MicroMidi/NUX-MIDI-Footswitch/images/NUX-Footswitch-Back.jpg

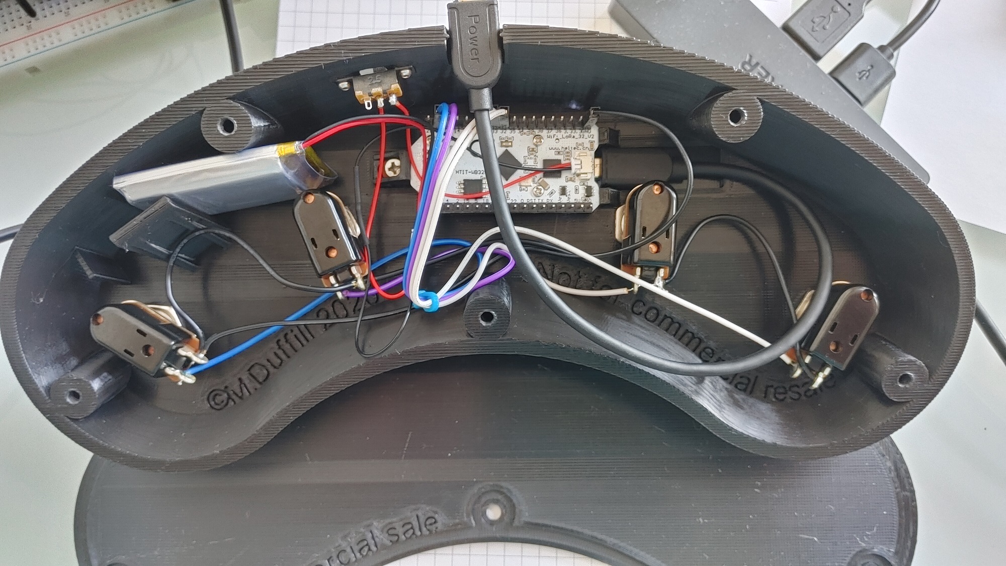
images/NUX-Footswitch-Back.jpg
