MicroMidi/NUX-MIDI-Footswitch/images/NUX-Footswitch-Front.jpg

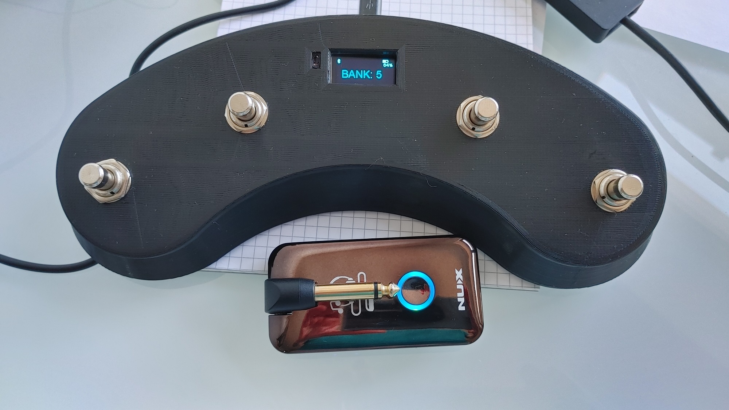
images/NUX-Footswitch-Front.jpg
