MicroMidi/NUX-MIDI-Footswitch/(threads)

Thread 1 (2022-06-10):

Generic ESP32 version?

Celticpure, 2022-06-10:
Any plans to release a generic ESP23 version for those not using the HELTEC boards?? Thank you for your hard work!

MicroMidi, 2022-06-12:
That should be possible - if an external SSD1306 OLED display will be attached to the ESP32 controller. Does this scenario match to your requirement?

Celticpure, 2022-06-12:
Yes that would be exactly my scenario. Thank you.

MicroMidi, 2022-06-29:
At least I have managed so far to modify the code in order to use the generic ESP32 board software and an external SSD1306 OLED library with my "Heltec ESP32 WiFi kit". So there are no longer any dependencies to Heltec software components and the code should work with all generic ESP32 devices that have an SSD1306 OLED display attached which is connected via I2C interface to the ESP32 module.

Final tests will be processed with an ESP32 WROVER module if my external SSD1306 display unit arrives that I ordered a couple of days ago.

So it seems that generic ESP32 support is almost close to release …

Celticpure, 2022-06-29:
Wow! Awesome work thank you for this. I will try and 1106 board also when I get back from holidays and let you know. It should work ok.

Celticpure, 2022-06-30:
Awesome, thank you so much. I will test in the next week or so and report back. Looking forward to this!

MicroMidi, 2022-07-22:
@Celticpure: Any results on testing the ESP32 version in your environment, yet?

Celticpure, 2022-07-22:
Yes the esp32 connects to the app fine. However the switches cannot change the banks. Nothing happens. I have rechecked the code to ensure correct pin assignment to the switches. Not sure what I might be missing here?

MicroMidi, 2022-07-22:
... the esp32 should connect directly to the Mighty Plug - the "Mightier" app is not needed in this setup. If this is the case in your scenario please doublecheck if the push buttons are tied to GND and not to VCC. The code initializes the ESP32-PINS for the push buttons with the "pull-up" feature. Hence, they are on VCC-level if they are not pushed. The push operation should change the level to GND and therefore the connection to GND is required. You can see that on the wiring scheme in the project description. Hope this helps ...

MicroMidi, 2022-08-05:
@Celticpure: Any need for further assistance or did you manage to get this to work?

MicroMidi, 2022-09-27:
"No news is good news" ...
No further response, I close this issue now with status "solved"

MicroMidi, 2022-09-27:
"No news is good news" ...
No further response, I close this issue now with status "solved"

Closed 2022-09-27.

Thread 2 (2023-03-02):

Is it active? / Mighty Plug Pro support

kozerskil, 2023-03-02:
Hello, this project is really interesting, is it still under active development? Do you know if it will support NUX Mighty Plug Pro?

MicroMidi, 2023-03-02:
Thanks for asking. Currently the project is not in an active development state as it works fine with the NUX Mighty Plug / Mighty Air.
I'm pretty sure that NUX uses the same MIDI CC-messages for bank switching and volume adjustments for the Mighty Plug Pro as for the Mighty Plug / Mighty Air. If this assumption is right the only necessary change in the code to get the Mighty Plug Pro to work is the adjustment of the MIDI device name for a successful pairing process.
Unfortunately I do not have a Mighty Plug Pro for test purposes. But if you like – just give it a try …

kozerskil, 2023-03-02:
Great, thanks. Next week I should get my device so I can try

kozerskil, 2023-03-06:
So I have my device, looks the advert name is "MIGHTY PLUG PRO" but I cannot connect using ESP32 neither with name nor with MAC. Any advice?

kozerskil, 2023-03-06:
In the lof I can see something like:
```
15:31:53.670 -> Advertised Device found: Name: MIGHTY PLUG PRO
15:31:53.670 -> Found MIDI Service
15:31:53.670 -> Name error
```

MicroMidi, 2023-03-06:
Did you adjust the definition of the MIDI device name in the code like this?:
#define MIDI_DEVICE_NAME "MIGHTY PLUG PRO"

Maybe it's a good starting point for testing to use the general client example of the BLE-MIDI-library:
https://github.com/lathoub/Arduino-BLE-MIDI/blob/master/examples/MidiBle_Client/MidiBle_Client.ino
Does this work in your environment?

kozerskil, 2023-03-06:
No, it's not working :(
```
Found MIDI Service
Name error
Advertised Device found: E (12783) task_wdt: Task watchdog got triggered. The following tasks did not reset the watchdog in time:
E (12783) task_wdt:  - IDLE (CPU 0)
E (12783) task_wdt: Tasks currently running:
E (12783) task_wdt: CPU 0: nimble_host
E (12783) task_wdt: CPU 1: loopTask
E (12783) task_wdt: Aborting.

abort() was called at PC 0x400ef045 on core 0

Backtrace: 0x40083915:0x3ffbeadc |<-CORRUPTED
```
Do you have any advice or should I look for a help on the other project?

kozerskil, 2023-03-06:
I found it's from here: https://github.com/lathoub/Arduino-BLE-MIDI/blob/master/src/hardware/BLEMIDI_Client_ESP32.h#L197

kozerskil, 2023-03-06:
Ok, that was helpful. With the code:
`BLEMIDI_CREATE_INSTANCE("",MIDI)`

That's interesting since in the log I can see:
```
---------CONNECTED---------
Connected to: MIGHTY PLUG PRO / [mac]
```
Looks like the name is the same but with
`BLEMIDI_CREATE_INSTANCE("MIGHTY PLUG PRO",MIDI)`
it didn't work.

Nevertheless, it's working now :)

MicroMidi, 2023-03-06:
This is good news👍. How did you manage to solve the error - with an empty device string? I'm surprised that the device name ist "MIGHTY PLUG PRO" and not "**NUX** MIGHTY PLUG PRO" - similar to the other NUX devices ...
May I ask what ESP32-module you use in your setup?

kozerskil, 2023-03-06:
I'm using some ESP32-DevKit clone just like this one: https://botland.store/esp32-wifi-and-bt-modules/8893-esp32-wifi-bt-42-platform-with-module-5904422337438.html
Regarding the name, yes, with `""` I was able to connect and what I can see in the monitor is `Connected to: MIGHTY PLUG PRO`.
My main issue was that my win10 shows different mac address of the device. When I connected using esp32 I copied the MAC it showed in the monitor and then code works fine with this value.

kozerskil, 2023-03-06:
Ok, I've done some testing. Connection is working fine, I can see it on esp end (in the serial monitor), on the NUX end (APP LED is turned on), but the effect is not changing when I push button on esp and esp doesn't notice effect change on NUX. MAybe magic "49" changed? Not sure, will be digging

kozerskil, 2023-03-06:
Where did you get the "49" from? I'm looking into this code https://github.com/tuntorius/mightier_amp/blob/main/lib/bluetooth/devices/communication/communication.dartt and looks like PRO communication changed significantly. Or maybe you see it otherwise?

MicroMidi, 2023-03-07:
The author of the Mightier-app published an Excel-Sheet with all the MIDI messages for the Mighty Plug 2 / Mighty Air. That was the starting point for my development efforts for these devices.
You're right - it seems that the Mighty Plug Pro uses a complete different set of MIDI commands based on MIDI-SysEx messages. I'm not familiar with Android app development and wasn't able to find the part of code in the app source code, that defines the MIDI message format for the Mighty Plug Pro, yet. Maybe it is worth a try to ask the developer of the Mightier app to help out?
I've already implemented a SysEx-message-based solution in my other footswitch projekt for the Vox ADIO amp. This code base should be easily adjustable to the Mighty Plug Pro - if we know the MIDI message formats for this device ...

kozerskil, 2023-03-07:
Mightier Amp is written in dart, it's rather easy to read. I can try to go through the code and combine it with your other project

MicroMidi, 2023-03-07:
I asked on facebook in the NUX Mighty Plug/Pro group for help on the MIDI commands for this device. The author of the Mightier app is also member of this group - probably he will help out ...

MicroMidi, 2023-03-07:
... the author of the Mightier App responded to my question in the facebook-group: NUX provides an desktop app for the Mighty Plug Pro ("MightyEditor") and this app has a feature to list all the MIDI commands of this device. Maybe you could give it a try ... ?

kozerskil, 2023-03-08:
Ok, I have it. Could you check with your device what should I be looking for? https://postimg.cc/gallery/tR9FndX

kozerskil, 2023-03-08:
Ok, that works :)
```
      byte adioEffect[] = { 0x80, 0x80, 0xc0, CurrentEffect };
      MIDI.sendSysEx(sizeof(adioEffect), adioEffect, true);
```

kozerskil, 2023-03-08:
The last missing puzzle is
```
MIDI.setHandleSystemExclusive([](byte * SysExArray, unsigned SysExSize)
```
For me it's not beeing called at all. Does it require any additional configuration? I've been looking into your other project and it looks pretty straighforward https://github.com/MicroMidi/VOX-Adio-Air-MIDI-Footswitch/blob/main/src/VOX-FS-MIDI-Client-GenericESP32-OLED.ino

MicroMidi, 2023-03-08:
This is a callback method that will be invoked, when the Vox Amp sends Midi messages to the footswitch. This happens when an effect bank is switched at the amp or the volume knob is adjusted. This method syncronizes the display of the footswitch with the changes that are applied directly at the amp. Hope this helps ...Gesendet von meinem Smartphone

kozerskil, 2023-03-08:
Yes, that's my understanding. And since Plug Pro is accepting PC with sendSysEx I was expecting I'll receive the callback call on program change directly on the Plug Pro. It doesn't happen though.

kozerskil, 2023-03-08:
Ok, I made it to have the callback called. When I change the preset on the Plug PRo, the callback is not beeing called, but when I ask from an esp about the preset it is beeing called. Here is the request:
```
      byte adioEffect[] = { 0x80, 0x80, 0xf0, 0x43, 0x58, 112, 12, 2, 0x80, 0xf7 };
      MIDI.sendSysEx(sizeof(adioEffect), adioEffect, true);
```
the values are comming from https://github.com/tuntorius/mightier_amp/blob/main/lib/bluetooth/devices/communication/plugProCommunication.dart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
Since I'm thinking about much simplier solution (next and prev is just enough for me) I'll probably stop my digging here. But if you'd like to do something more, I'm keen to help/test on my device.

Thank you for all your help!
I was thinking to implement something like this before I found you repo and now I see that without you work and help it wouldn't be possible ;)

MicroMidi, 2023-03-09:
Thanks for all your investigations and feedback - highly appreciated🙏. I'm surprised that your approach with SysEx-messages works to switch through the presets - your screenshots of the desktop app shows that a MIDI "program change" is the relevant command for that. And I guess that switching through the presets at the NUX device will also generate a MIDI "program change" message - so if you want to "catch" those messages in the ESP32-code you need to implement a "setHandleProgramChange()" callback method ...
But this is all just guessing. I’m thinking about getting a MP Pro device myself to implement support for this device in my project. Probably in combination with an ESP32/S3 microcontroller that support wireless BLE-MIDI and USB-MIDI in parallel. We’ll see if I find the time for that …

tuntorius, 2023-03-11:
Mighty Plug Pro channels are set using Program Change messages. I'm not familiar with the library you're using, but I think it can't be right that you're trying to send a PC message using the sendSysEx method. There must be a specific method for PC messages.

The code from Mightier Amp you linked is for requesting the current channel, not setting it. The code for setting the channel is at line 245.

kozerskil, 2023-03-13:
> The code from Mightier Amp you linked is for requesting the current channel, not setting it. The code for setting the channel is at line 245.

Yes, I know. My last comment was about requesting the preset and having the callback called. To make a PC I use this:
```
      byte adioEffect[] = { 0x80, 0x80, 0xc0, CurrentEffect };
      MIDI.sendSysEx(sizeof(adioEffect), adioEffect, true);
```
and my understanding is that's what you do here:
https://github.com/tuntorius/mightier_amp/blob/main/lib/bluetooth/devices/communication/plugProCommunication.dart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
https://github.com/tuntorius/mightier_amp/blob/main/lib/bluetooth/devices/communication/communication.dart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

But it's not clear for me how to send the payload. You say you are not using sendSysEx?

tuntorius, 2023-03-13:
I'm not using SysEx. The setChannel method from the first link is calling createPCMessage from the second link. No SysEx is involved here. If you look a bit further at the source in the second link. There are 2 SysEx functions. None of those are called from SetChannel or CreatePCmessage functions.

Currently, your code is creating a PC message and wrapping it in a SysEx message. That won't work.

kozerskil, 2023-03-13:
Ok, you are right. For some reason the old code worked as well, but now, it's working both ways with this code:
* setting:
```
  MIDI.sendProgramChange(CurrentEffect, 1);
```

* reading:
```
  MIDI.setHandleProgramChange(myProgramChange);

void myProgramChange(byte channel, byte program) {
  Serial.print("Program Change, ch=");
  Serial.print(channel, DEC);
  Serial.print(", program=");
  Serial.println(program, DEC);
}
```

tuntorius, 2023-03-13:
Unfortunately, both devices don't have proper master volume. For MP-2 there's just amp volume. MP Pro has a master volume at midi cc 73, but it's a per channel volume. It won't keep your setting it you change to another channel. Worse, it won't remember the volume of channel 1 if you change to channel 2 and then back. Even worse - this "master" volume is not tied to the physical buttons volume and also, pressing the buttons will not emit any midi messages.

I implemented master volume for the MP 2 in mightier amp, but it's fake. It simply scales down the volume of the amp.

MicroMidi, 2023-03-14:
Thanks again @tuntorius for sharing your detailed knowledge of the NUX devices in this project👍.
It looks that it's a relatively easy task now to adjust my code for the MP2 to support the MP Pro, too. I'll publish new the code here in this project as soon as I finished my work.

I also implemented a "fake master volume" in my code for the MP 2 when an analog effect pedal is attached: As soon as the volume pedal changes its volume level I store the respective value in a global variable. When the user changes the channel at the footswitch or at the device I apply this volume level to the new channel. This is not a real master volume functionality as the channels have very different volumes itself - based on the configured amp and gain settings. But in practice I find this volume adjustment a very useful feature as a general volume level is assured for all channels and fine tuning can be applied with the volume pedal...

MicroMidi, 2023-03-14:
I published a first beta version of the code supporting the NUX Mighty Plug Pro. You will find it here:
https://github.com/MicroMidi/NUX-MIDI-Footswitch/blob/main/src/beta/NUX-Pro-FS-MIDI-Client-GenericESP32-OLED.ino

All I had to do is to ...
- change the midi commands for channel switching to MIDI-ProgramChange messages
- implement a MIDI-ProgramChange callback method for catching MIDI messages when a channel is changed at the NUX device
- adjust the MIDI-ControlChange commands for adjusting the volume when a channel changes

As I don't own a Mighty Plug Pro myself it would be great if someone could test the code - thanks in advance for your support👍

kozerskil, 2023-03-16:
Ok, I tested it. Program changes are working as expected. Callback is working as expected. I have no way to test volume changes.
There is still an issue with initial connection, for me there is no device name I can provide here MIDI_DEVICE_NAME, it only works with empty value or MAC.

MicroMidi, 2023-03-17:
Thanks for testing, @kozerskil🙏. Do you have a display attached to the ESP32-module and does the channel at the ESP32 change when you press the channel-switch button at the NUX device? If not, then this line should be modified ...
https://github.com/MicroMidi/NUX-MIDI-Footswitch/blob/46e5591a8faf10cb8da6b93d6ef17fbd7a53f8c5/src/beta/NUX-Pro-FS-MIDI-Client-GenericESP32-OLED.ino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
... to "CurrentEffect = Channel;"

I definitely recommend to attach an analogue volume pedal to the ESP32 module. It's a nice feature to switch the channels with the footswitch though - but without volume adjustment it almost unusable as the volume level is so different on all channels. With an attached volume pedal the volume level of the pedal is applied to the new channel, when a channel switch occurs and you can apply further fine tuning of the volume with the pedal. This works really nice - and makes the solution complete…

kozerskil, 2023-04-25:
Ok, finally, after receiving all the goods from aliexpress, here is my solution: https://youtu.be/RgiLf9BnJXk
Thanks @MicroMidi for your awsome work!

Closed 2023-04-25.

Thread 3 (2025-04-13):

Receive callback NUX BLE MIDI

GooseG4G, 2025-04-13:
I'm trying to figure out the NUX BLE MIDI message protocol. I've been able to send messages to change the NUX Mighty space configuration:
[
    2byte $(timestamp),
    0xB0,
    2byte $(ID of the effects loop element) or &(ID of the effects loop element switch),
    2byte $(VALUE) or $(INDEX)
]

I'm having trouble querying the current amp configuration and getting a response over BLE MIDI.
What message format is used to query the current configuration?

MicroMidi, 2025-04-14:
... in my project I use only commands to switch presets and control the volume of the nux device - there are no queries implemented. Maybe the following project is worth looking at, as the app implements a lot a features provided by the NUX devices:
https://github.com/tuntorius/mightier_amp
Good luck🙏
