MicroMidi/NUX-MIDI-Footswitch/(commit log)

2022-01-19 Update NUX-FS-MIDI-Client.ino
    Improved timing for initialization: Reset t0-timer in connection callback method
2022-06-08 Update NUX-FS-MIDI-Client-OLED.ino
    Incorporated an option to attach an anlog effect pedal for adjusting the master volume of the NUX device
2022-06-08 Update NUX-FS-MIDI-Client-OLED.ino
    Added an option to attach an analog effect pedal to adjust the master volume of the NUX device
2022-06-30 Create NUX-FS-MIDI-Client-GenericESP32-OLED.ino
    Initial version for generic ESP32 devices with external SSD1306 OLED display
2022-07-01 Add files via upload
    Wiring scheme for generic ESP32 devices with external SSD1306 OLED display unit
2022-07-01 Update README.md
    Added information for generic ESP32 variant
2022-07-01 Add files via upload
    Wiring schema for variant with generic ESP32 module
2022-07-01 Update README.md
    Added library information for the variant with generic ESP32 module
2022-07-03 Update README.md
    Picture of generic ESP32 prototype added
2022-07-03 Add files via upload
    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
2023-03-14 Added beta version for NUX Mighty Plug Pro on ESP32-platform
